benmola/PowerA_Xbox_One_Mod/docs/pico_pinout.png

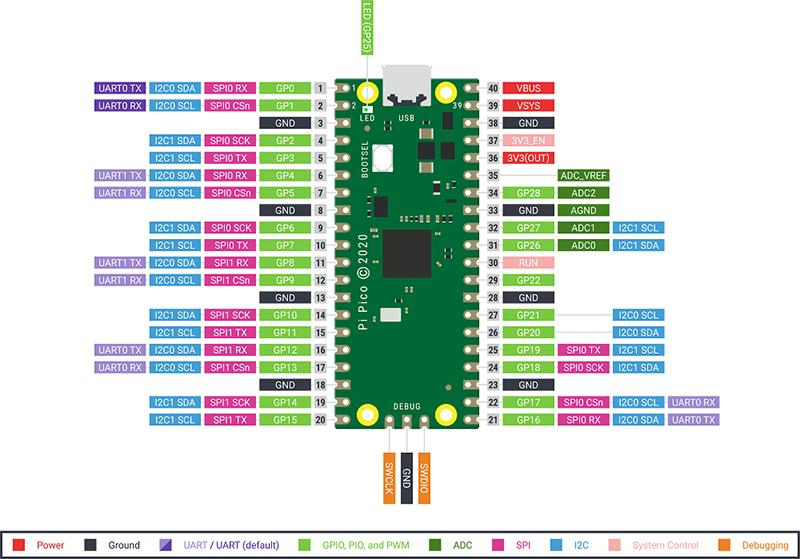
docs/pico_pinout.png
