benmola/PowerA_Xbox_One_Mod/docs/nrf24l01_pinout.png

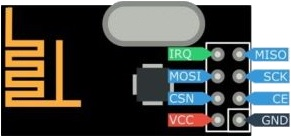
docs/nrf24l01_pinout.png
