benmola/PowerA_Xbox_One_Mod/docs/nrf24l01_module_2.jpg

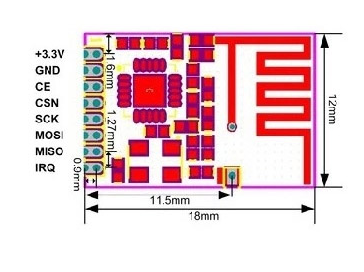
docs/nrf24l01_module_2.jpg
