benmola/PowerA_Xbox_One_Mod/build/picotool/tmp/picotoolBuild-cfgcmd.txt

cmd='C:/Program Files/CMake/bin/cmake.exe;--no-warn-unused-cli;-DCMAKE_MAKE_PROGRAM:FILEPATH=C:/Users/bdekh/AppData/Local/Microsoft/WinGet/Links/ninja.exe;-DPICO_SDK_PATH:FILEPATH=G:/PowerA Controller Project/pico-sdk;-DPICOTOOL_NO_LIBUSB=1;-DPICOTOOL_FLAT_INSTALL=1;-DCMAKE_INSTALL_PREFIX=G:/PowerA Controller Project/PowerA_Xbox_One_Modd_New/PowerA_Xbox_One_Mod/build/_deps;-DCMAKE_RULE_MESSAGES=OFF;-DCMAKE_INSTALL_MESSAGE=NEVER;-GNinja;-S;<SOURCE_DIR><SOURCE_SUBDIR>;-B;<BINARY_DIR>'
