benmola/PowerA_Xbox_One_Mod/build/picotool/src/picotoolBuild-stamp/picotoolBuild-source_dirinfo.txt

# This is a generated file and its contents are an internal implementation detail.
# The download step will be re-executed if anything in this file changes.
# No other meaning or use of this file is supported.

method=source_dir
command=
source_dir=G:/PowerA Controller Project/PowerA_Xbox_One_Modd_New/PowerA_Xbox_One_Mod/build/_deps/picotool-src
work_dir=
