benmola/PowerA_Xbox_One_Mod/build/_deps/picotool-subbuild/picotool-populate-prefix/src/picotool-populate-stamp/picotool-populate-update-info.txt

# This is a generated file and its contents are an internal implementation detail.
# The patch step will be re-executed if anything in this file changes.
# No other meaning or use of this file is supported.

command (connected)=C:/Program Files/CMake/bin/cmake.exe;-Dcan_fetch=YES;-DCMAKE_MESSAGE_LOG_LEVEL=VERBOSE;-P;G:/PowerA Controller Project/PowerA_Xbox_One_Modd_New/PowerA_Xbox_One_Mod/build/_deps/picotool-subbuild/picotool-populate-prefix/tmp/picotool-populate-gitupdate.cmake
command (disconnected)=C:/Program Files/CMake/bin/cmake.exe;-Dcan_fetch=NO;-DCMAKE_MESSAGE_LOG_LEVEL=VERBOSE;-P;G:/PowerA Controller Project/PowerA_Xbox_One_Modd_New/PowerA_Xbox_One_Mod/build/_deps/picotool-subbuild/picotool-populate-prefix/tmp/picotool-populate-gitupdate.cmake
work_dir=G:/PowerA Controller Project/PowerA_Xbox_One_Modd_New/PowerA_Xbox_One_Mod/build/_deps/picotool-src
