benmola/PowerA_Xbox_One_Mod/build/pico-sdk/src/rp2_common/pico_cyw43_driver/pioasm/tmp/pioasmBuild-cfgcmd.txt

cmd='C:/Program Files/CMake/bin/cmake.exe;--no-warn-unused-cli;-DCMAKE_MAKE_PROGRAM:FILEPATH=C:/Users/bdekh/AppData/Local/Microsoft/WinGet/Links/ninja.exe;-DPIOASM_FLAT_INSTALL=1;-DCMAKE_INSTALL_PREFIX=G:/PowerA Controller Project/PowerA_Xbox_One_Modd_New/PowerA_Xbox_One_Mod/build/pioasm-install;-DCMAKE_RULE_MESSAGES=OFF;-DCMAKE_INSTALL_MESSAGE=NEVER;-GNinja;-C<TMP_DIR>/pioasmBuild-cache-$<CONFIG>.cmake;-S;<SOURCE_DIR><SOURCE_SUBDIR>;-B;<BINARY_DIR>'
