benmola/PowerA_Xbox_One_Mod/(commit log)

2026-04-13 modified: CMakeLists.txt new file: OLD_Code deleted: Project/Wireless_Controller_Guide.md new file: Wireless_Controller_Guide.md modified: build/.ninja_deps modified: build/.ninja_log modified: build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
2026-04-15 modified: .claude/settings.local.json modified: README.md deleted: Wireless_Controller_Guide.md deleted: bin_to_uf2.py new file: docs/nicenano_nrf52840.jfif renamed: image.png -> docs/nrf24l01_dip_pi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
